Milan2mecha/zdroj/stl/drzak_izolatoru.stl

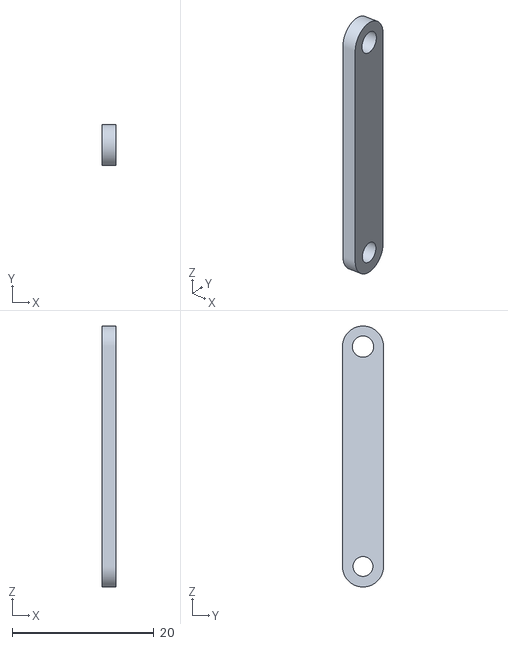
[picture p23: CAD file, 2023-06-30]
stl/drzak_izolatoru.stl
2.00 x 5.80 x 36.8
