Milan2mecha/zdroj/stl/zadní kryt.stl

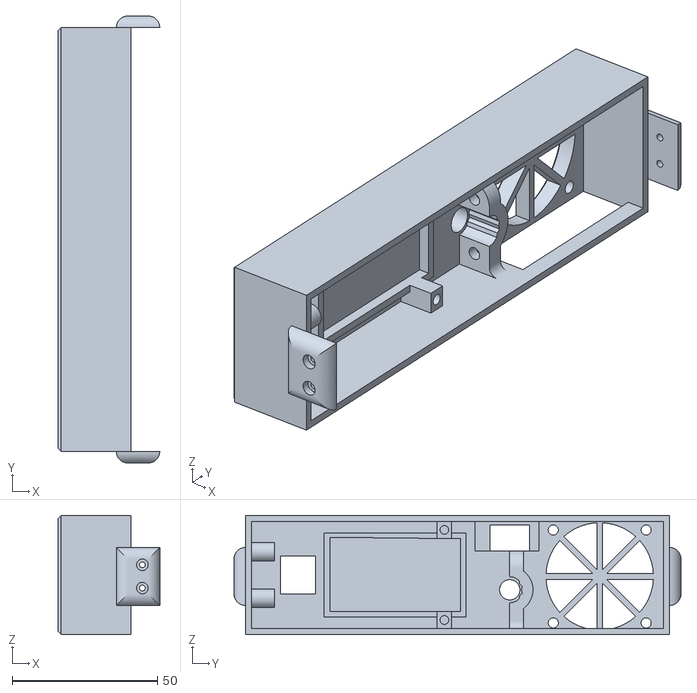
[picture p24: CAD file, 2023-04-14]
stl/zadní kryt.stl
35.0 x 154.0 x 41.0
