Milan2mecha/zdroj/stl/západka.stl

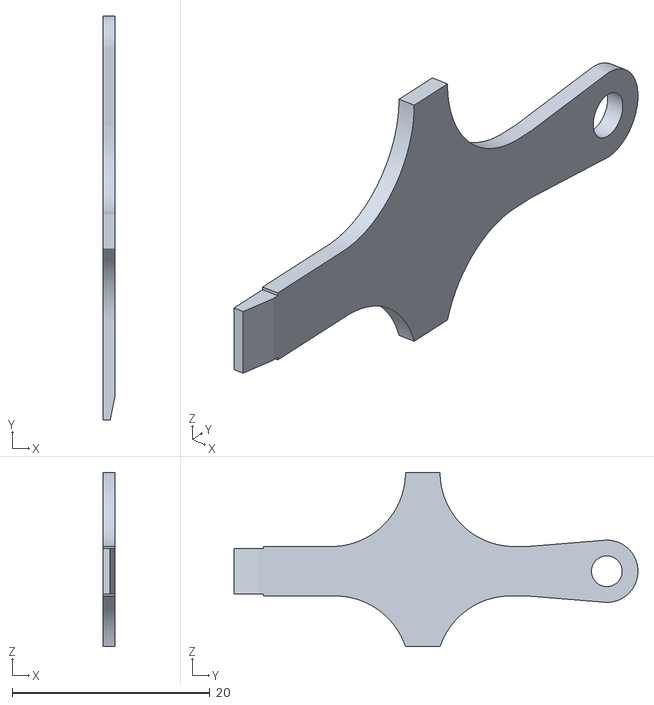
[picture p25: CAD file, 2022-03-03]
stl/západka.stl
1.25 x 40.8 x 17.6
