Milan2mecha/zdroj/stl/uchytka desek.stl

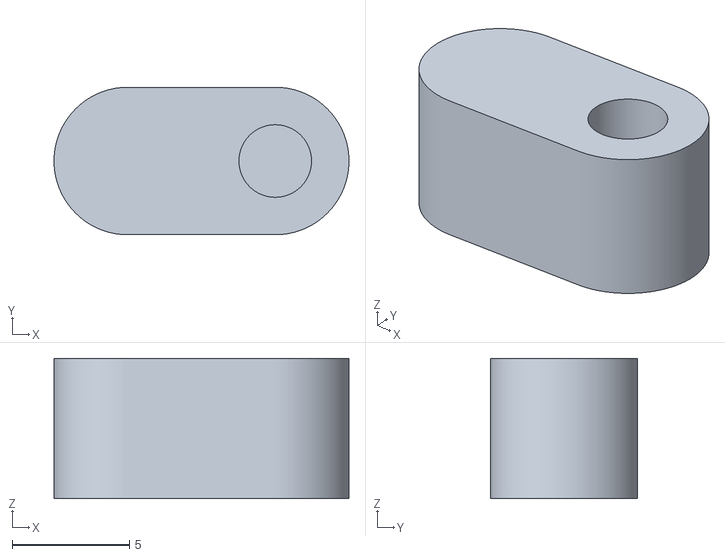
[picture p26: CAD file, 2022-02-09]
stl/uchytka desek.stl
12.6 x 6.30 x 6.00
