Milan2mecha/zdroj/stl/clona.stl

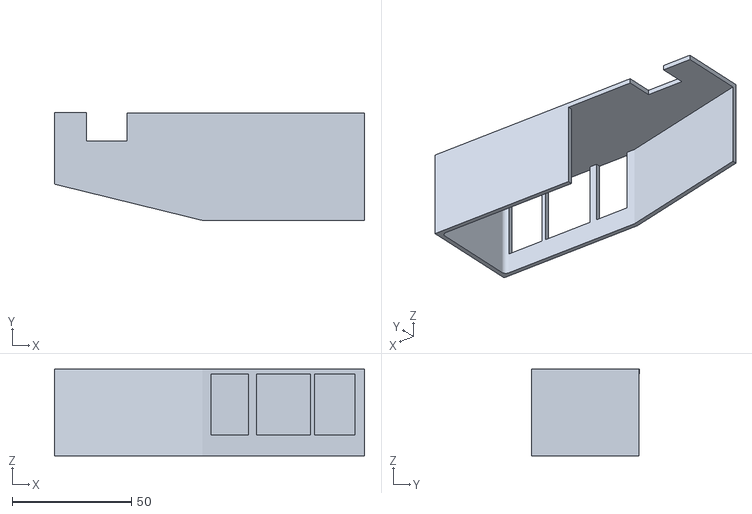
[picture p27: CAD file, 2022-02-09]
stl/clona.stl
130.0 x 45.2 x 36.4
