Milan2mecha/zdroj/stl/krytka enkoderu v2.stl

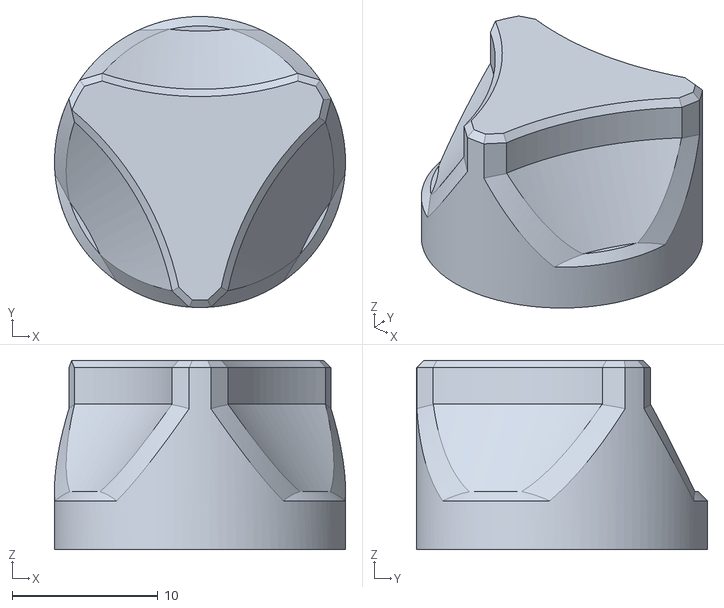
[picture p28: CAD file, 2022-01-17]
stl/krytka enkoderu v2.stl
20.0 x 20.0 x 13.0
