Milan2mecha/zdroj/stl/left.stl

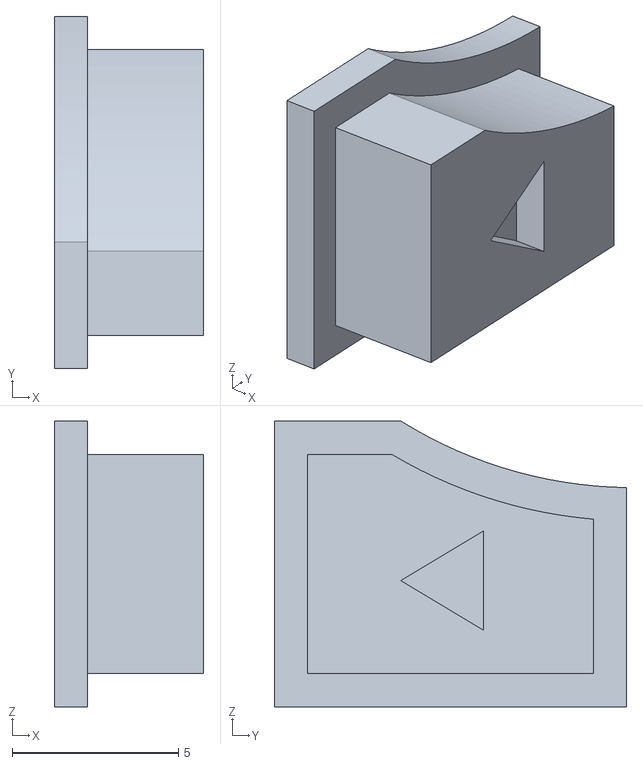
[picture p29: CAD file, 2022-01-17]
stl/left.stl
4.50 x 10.6 x 8.60
