Milan2mecha/zdroj/stl/příchytka.stl

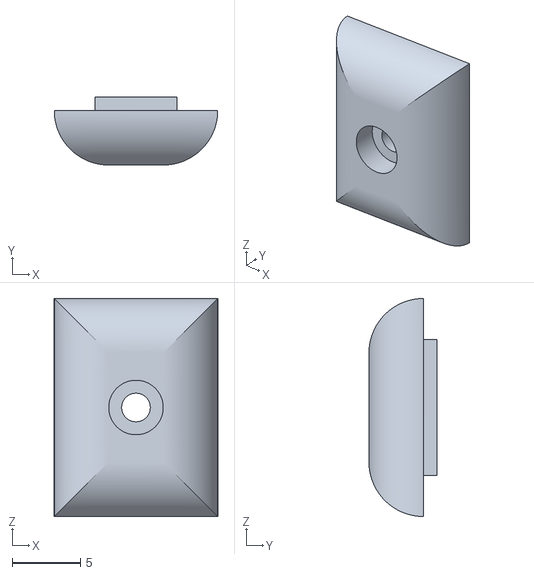
[picture p30: CAD file, 2022-01-17]
stl/příchytka.stl
12.0 x 5.00 x 16.0
