Milan2mecha/zdroj/stl/menu.stl

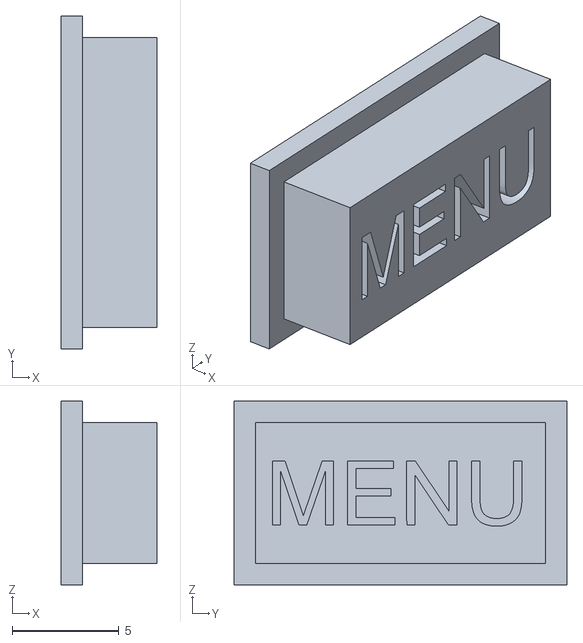
[picture p31: CAD file, 2022-01-17]
stl/menu.stl
4.50 x 15.6 x 8.60
