Milan2mecha/zdroj/stl/ovládací panel.stl

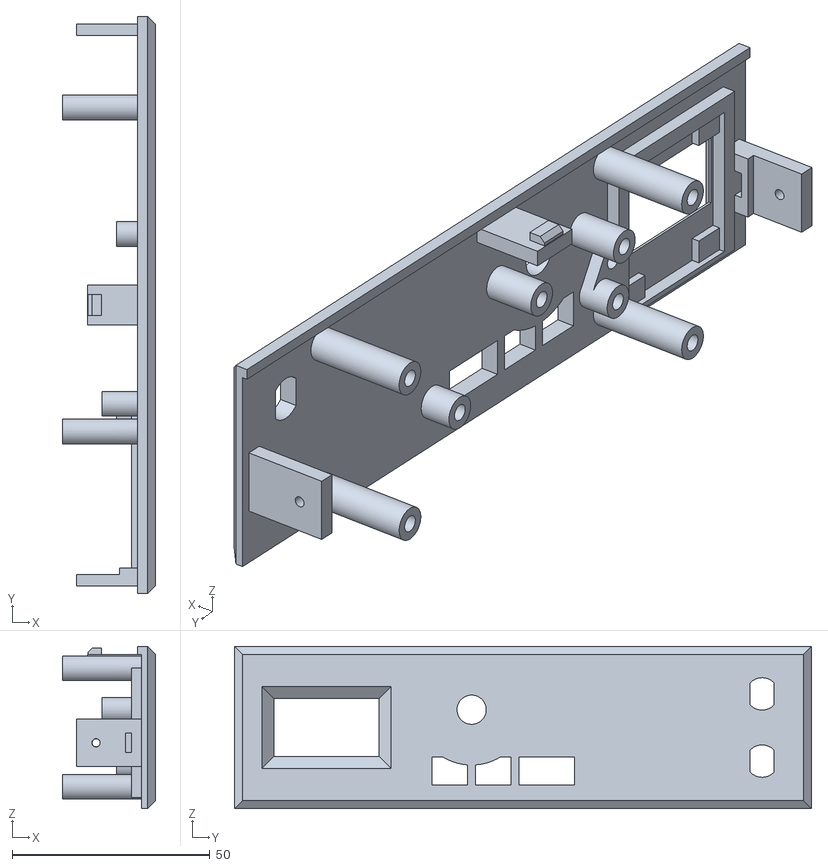
[picture p32: CAD file, 2022-01-17]
stl/ovládací panel.stl
23.5 x 146.0 x 41.0
