Milan2mecha/zdroj/(list of files, cad)

Other CAD files:
stl/right.stl
