Milan2mecha/zdroj/schéma.pdf

# Deska microkontroleru STM32F103C8T6

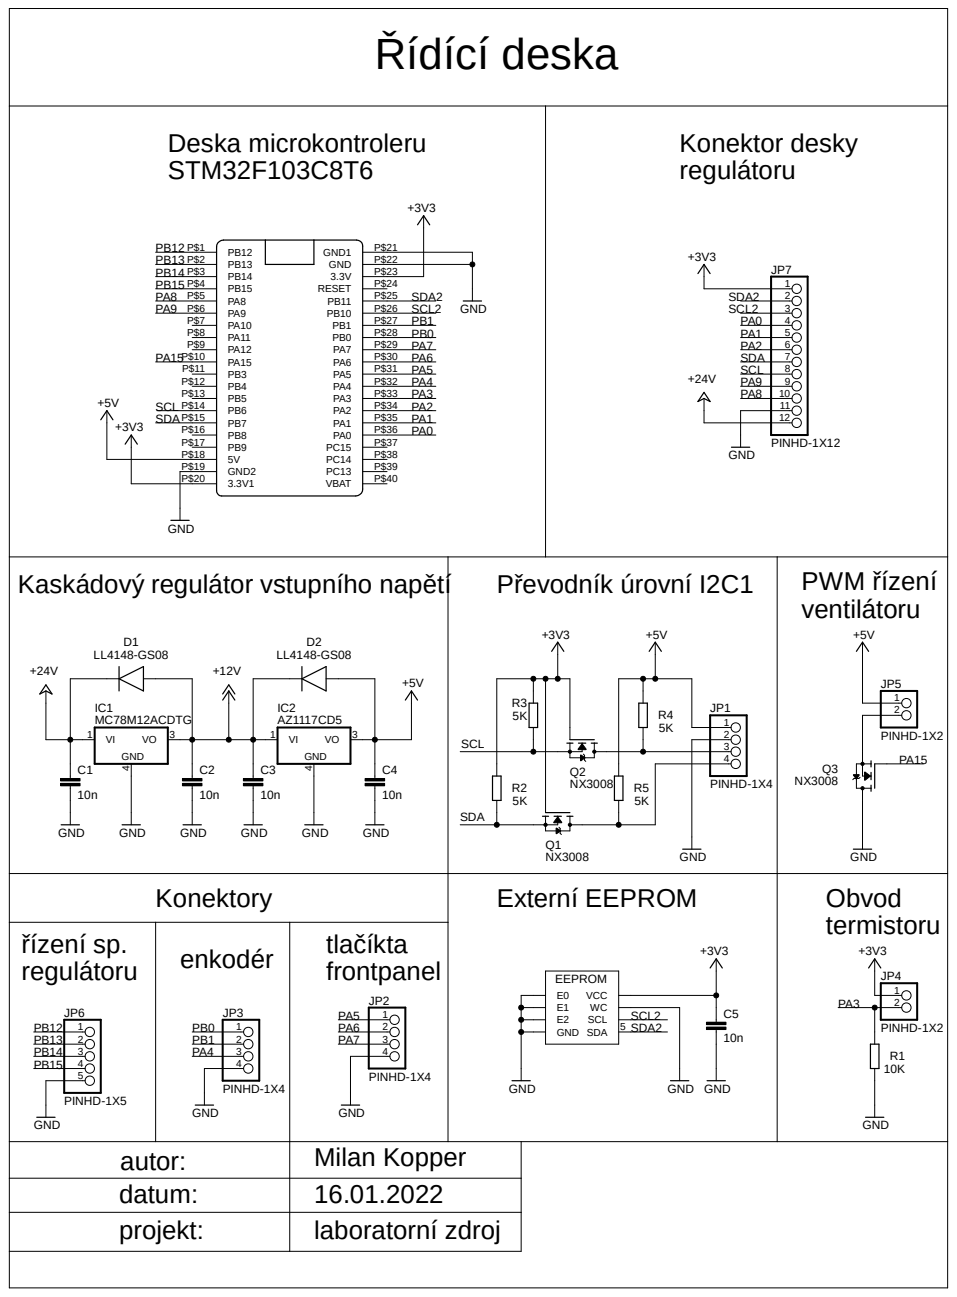
[picture p33: page 1]

Kaskádový regulátor vstupního napětí

autor: | Milan Kopper
datum: | 16.01.2022
projekt: | laboratorní zdroj
