Milan2mecha/zdroj/clona.pdf

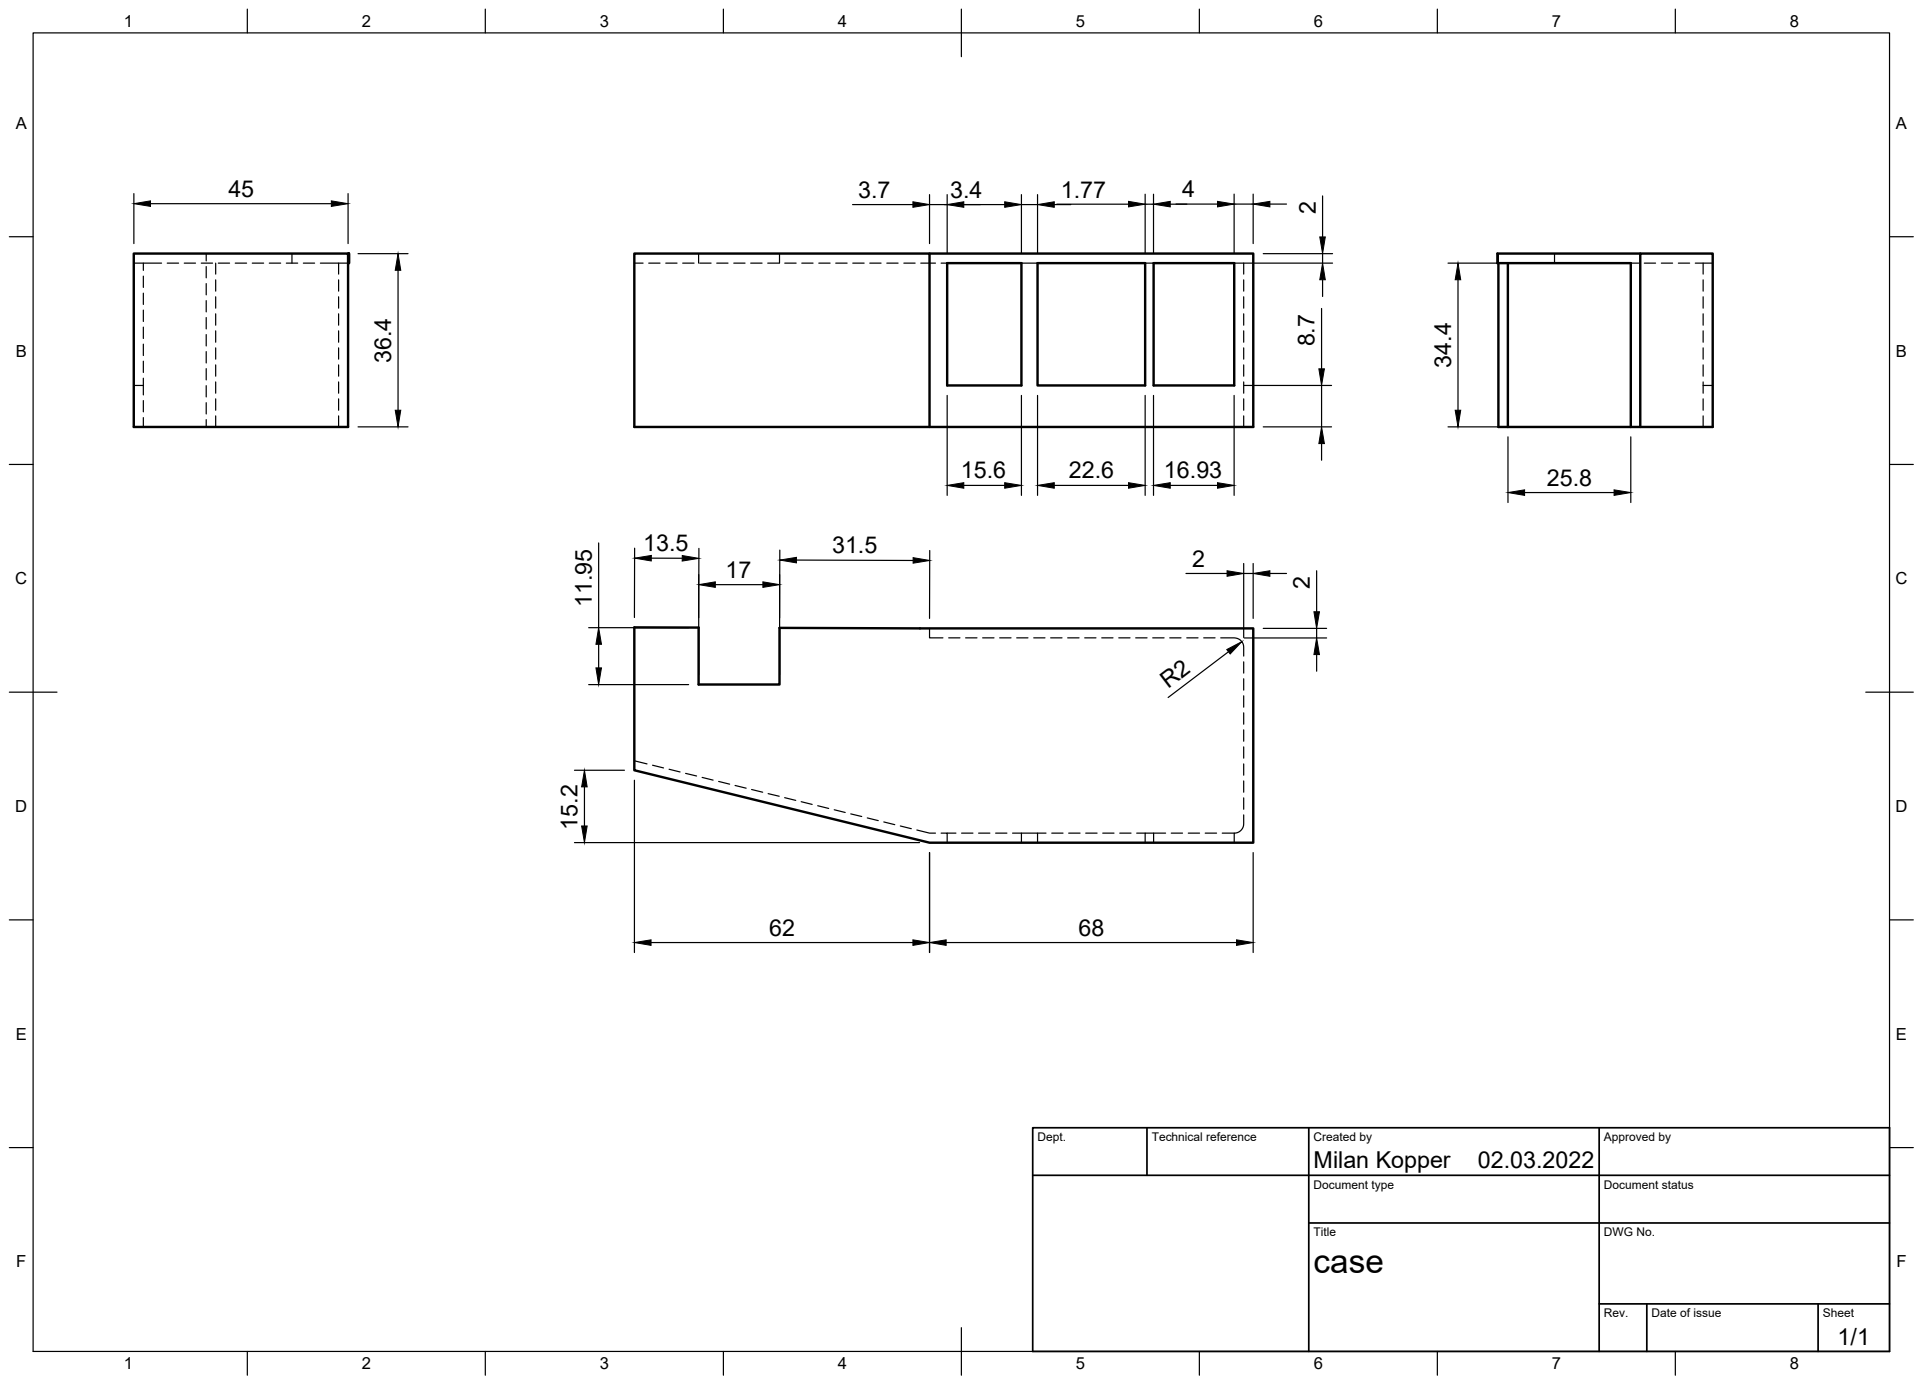
[picture p34: page 1]
Title; DWG No.; Rev.; Date of issue; Sheet

Dept. | Technical reference | Created by Milan Kopper 02.03.2022 | Approved by

Document type | Document status
