Milan2mecha/zdroj/příchytka.pdf

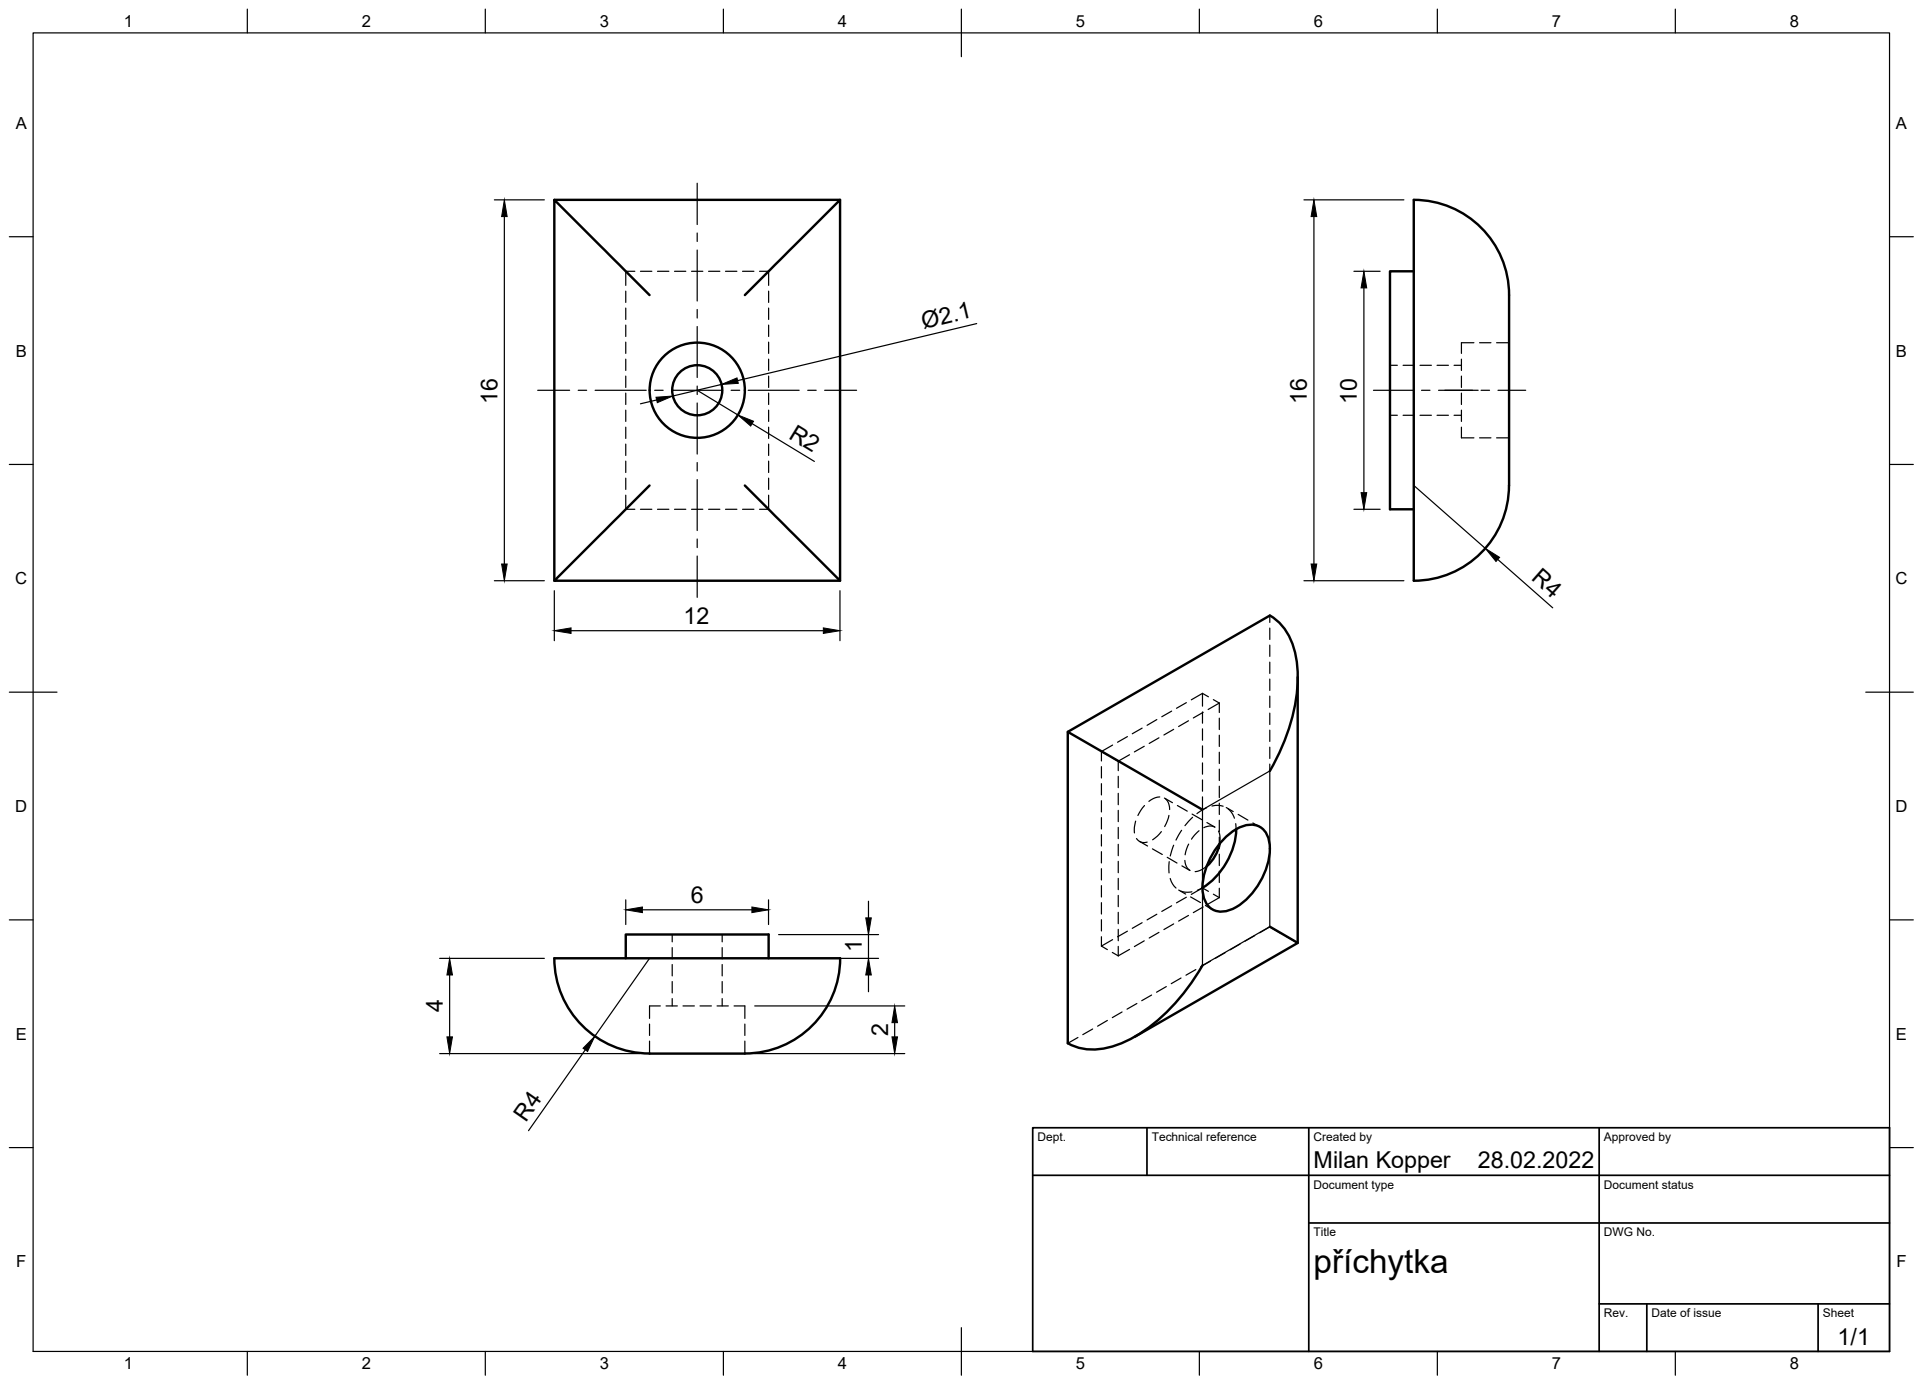
[picture p35: page 1]
Title; DWG No.; Rev.; Date of issue; Sheet

Dept. | Technical reference | Created by Milan Kopper 28.02.2022 | Approved by

Document type | Document status
