Milan2mecha/zdroj/ovládací panel.pdf

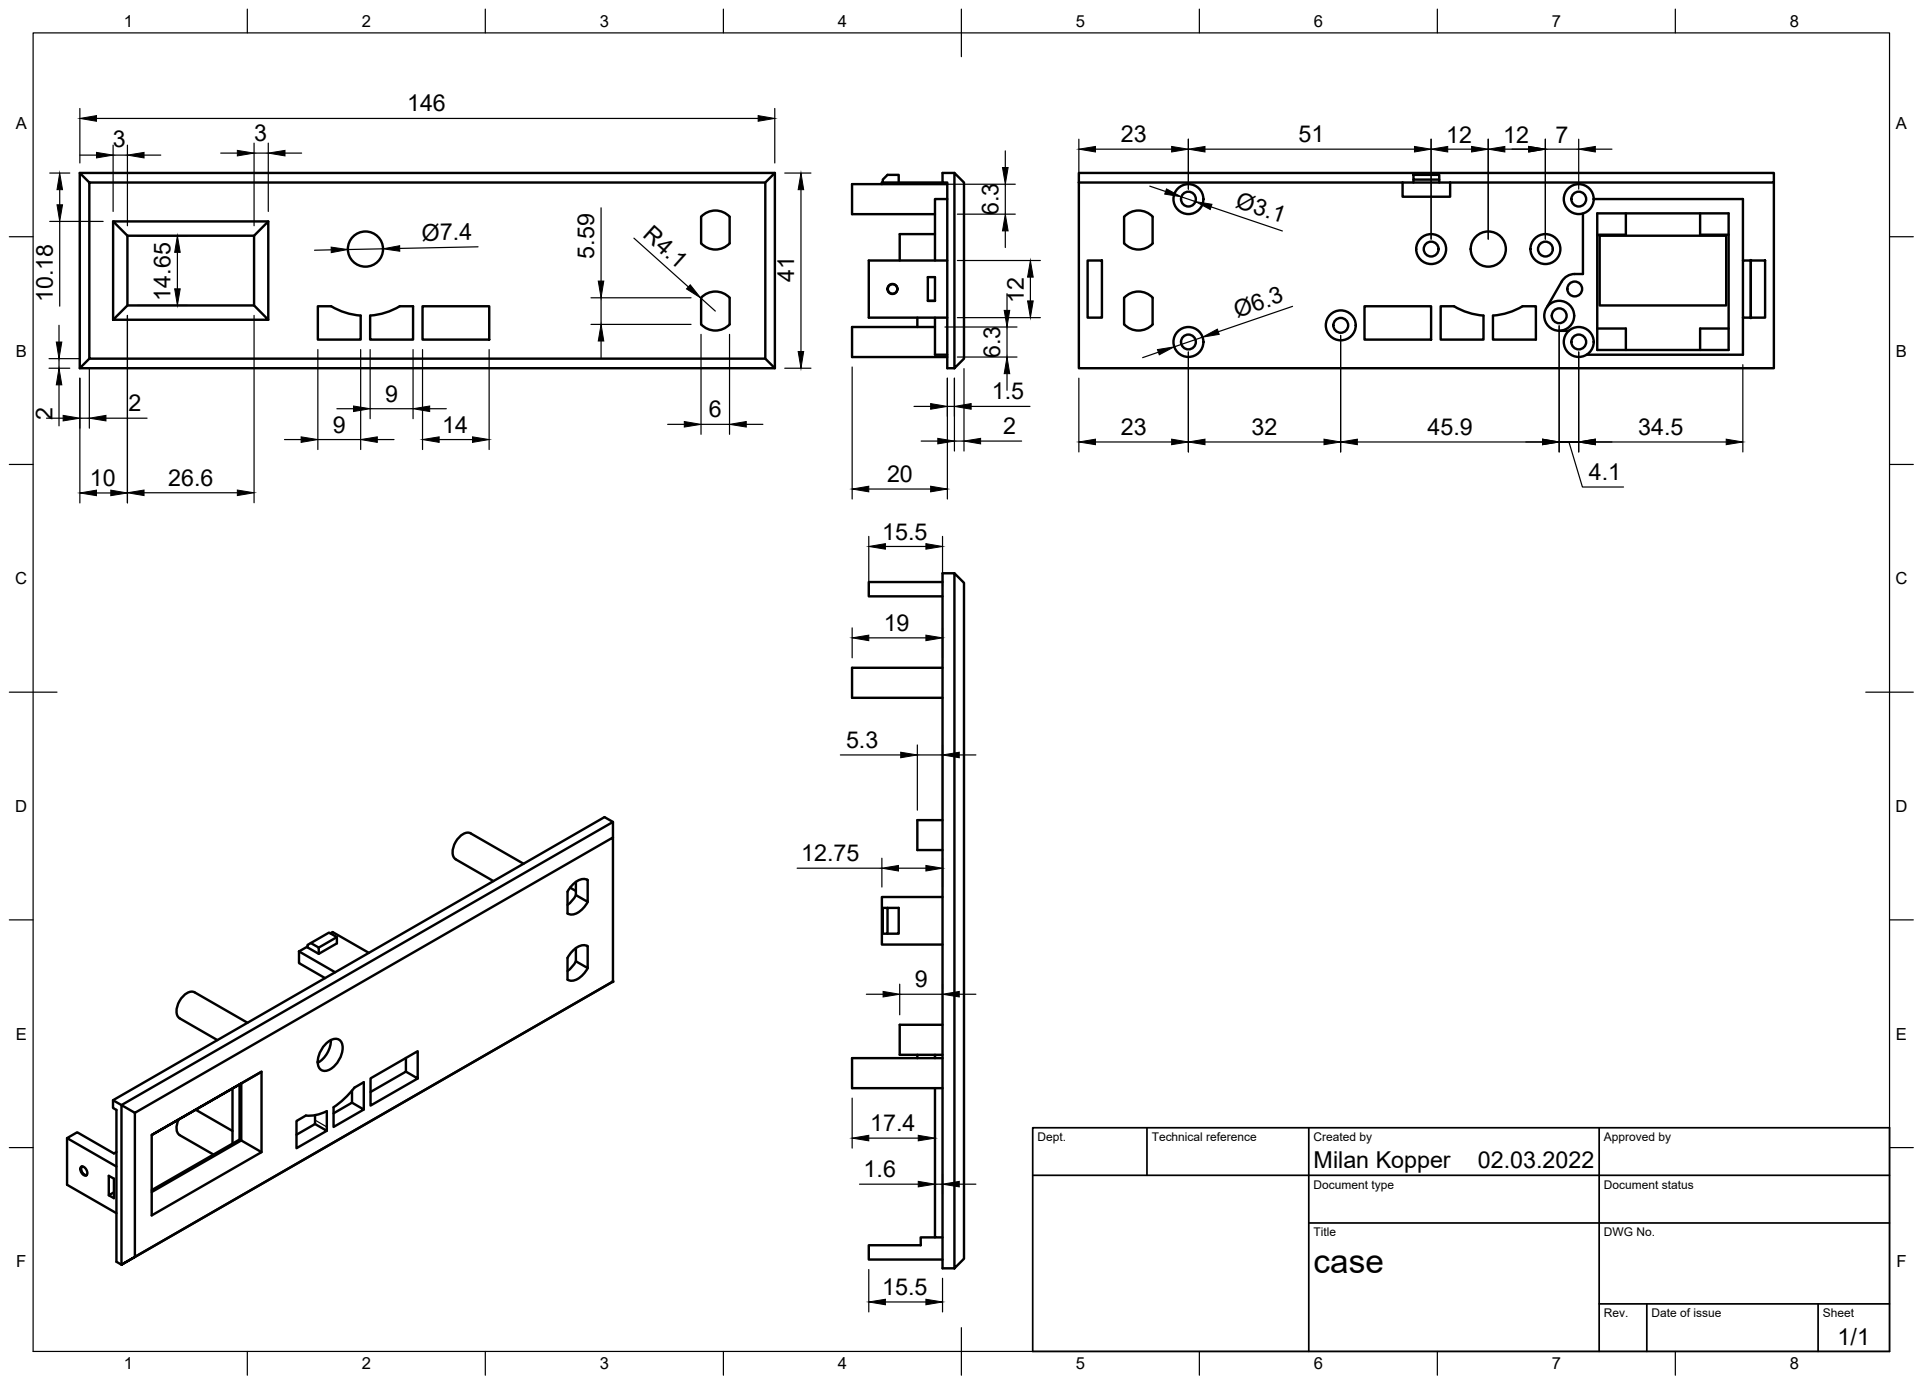
[picture p36: page 1]
Title; DWG No.; Rev.; Date of issue; Sheet; Milan Kopper 41

Dept. | Technical reference | Created by 02.03.2022 | Approved by

Document type | Document status
