Milan2mecha/zdroj/desky plošných spojů/řídicí deska.brd

## EAGLE design desky plošných spojů/řídicí deska.brd (2022-02-02)

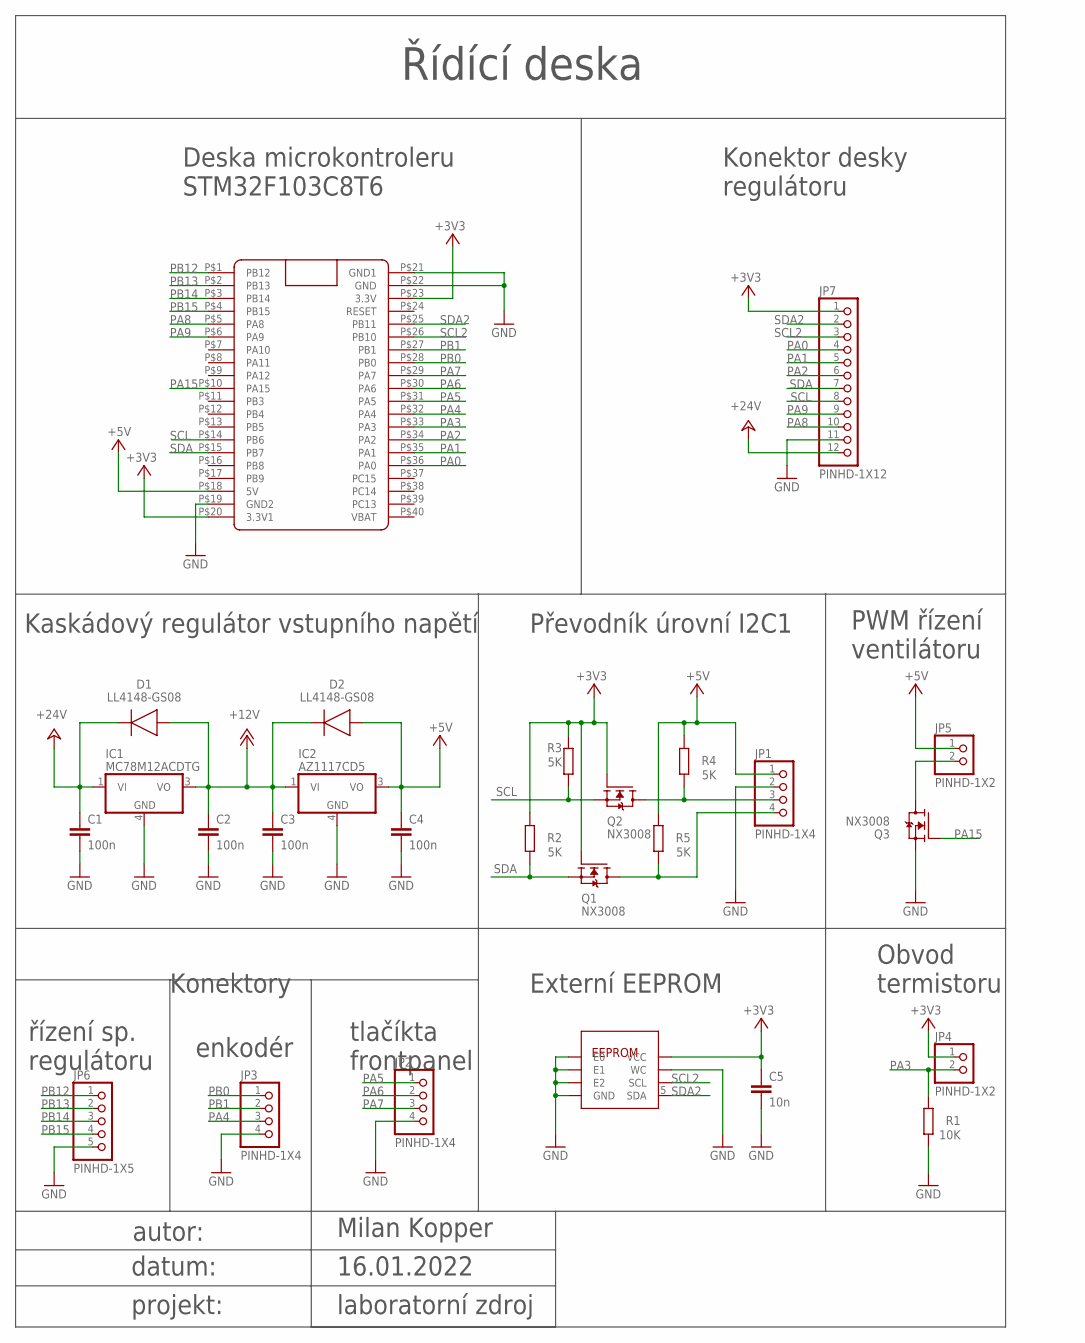
[picture p37: schematic řídicí deska.sch]

Parts:
C1, C2, C3, C4: 100n; C0805
C5: 10n; C0805
D1, D2: LL4148-GS08; DIOMELF3516
IC1: MC78M12ACDTG; DPACK_3
IC2: AZ1117CD5; DPACK_3
JP1, JP2, JP3: PINHD-1X4; 1X04
JP4, JP5: PINHD-1X2; 1X02
JP6: PINHD-1X5; 1X05
JP7: PINHD-1X12; 1X12
Q1, Q2, Q3: NX3008; SOT95P240X110-3N
R1: 10K; R0805
R2, R3, R4, R5: 5K; R0805
U$1: BLUE_PILL
U$2: M24CXX; SO8

Connections:
+3V3: C5.1, JP4.1, JP7.1, Q1.1 (G), Q2.1 (G), R2.2, R3.2, U$1.P$20 (3.3V1), U$1.P$23 (3.3V), U$2.8 (VCC)
+5V: C4.1, D2.2 (A), IC2.3 (VO), JP1.1, JP5.1, R4.2, R5.2, U$1.P$18 (5V)
+12V: C2.1, C3.1, D1.2 (A), D2.1 (C), IC1.3 (VO), IC2.1 (VI)
+24V: C1.1, D1.1 (C), IC1.1 (VI), JP7.12
GND: C1.2, C2.2, C3.2, C4.2, C5.2, IC1.4 (GND), IC2.4 (GND), JP1.2, JP2.4, JP3.4, JP6.5, JP7.11, Q3.2 (S), R1.1, U$1.P$19 (GND2), U$1.P$21 (GND1), U$1.P$22 (GND), U$2.1 (E0), U$2.2 (E1), U$2.3 (E2), U$2.4 (GND), U$2.7 (WC)
unnamed: JP5.2, Q3.3 (D)
unnamed: JP1.3, Q2.3 (D), R4.1
unnamed: JP1.4, Q1.3 (D), R5.1
PA0: JP7.4, U$1.P$36 (PA0)
PA1: JP7.5, U$1.P$35 (PA1)
PA2: JP7.6, U$1.P$34 (PA2)
PA3: JP4.2, R1.2, U$1.P$33 (PA3)
PA4: JP3.3, U$1.P$32 (PA4)
PA5: JP2.1, U$1.P$31 (PA5)
PA6: JP2.2, U$1.P$30 (PA6)
PA7: JP2.3, U$1.P$29 (PA7)
PA8: JP7.10, U$1.P$5 (PA8)
PA9: JP7.9, U$1.P$6 (PA9)
PA15: Q3.1 (G), U$1.P$10 (PA15)
PB0: JP3.1, U$1.P$28 (PB0)
PB1: JP3.2, U$1.P$27 (PB1)
PB12: JP6.1, U$1.P$1 (PB12)
PB13: JP6.2, U$1.P$2 (PB13)
PB14: JP6.3, U$1.P$3 (PB14)
PB15: JP6.4, U$1.P$4 (PB15)
SCL: JP7.8, Q2.2 (S), R3.1, U$1.P$14 (PB6)
SCL2: JP7.3, U$1.P$26 (PB10), U$2.6 (SCL)
SDA: JP7.7, Q1.2 (S), R2.1, U$1.P$15 (PB7)
SDA2: JP7.2, U$1.P$25 (PB11), U$2.5 (SDA)

Notes on the sheet:
Kaskádový regulátor vstupního napětí
Konektory
řízení sp. regulátoru
enkodér
tlačíkta frontpanel
Externí EEPROM
Převodník úrovní I2C1
Obvod termistoru
PWM řízení ventilátoru
Deska microkontroleru STM32F103C8T6
Konektor desky regulátoru
Řídící deska
autor:
datum:
projekt:
Milan Kopper
16.01.2022
laboratorní zdroj

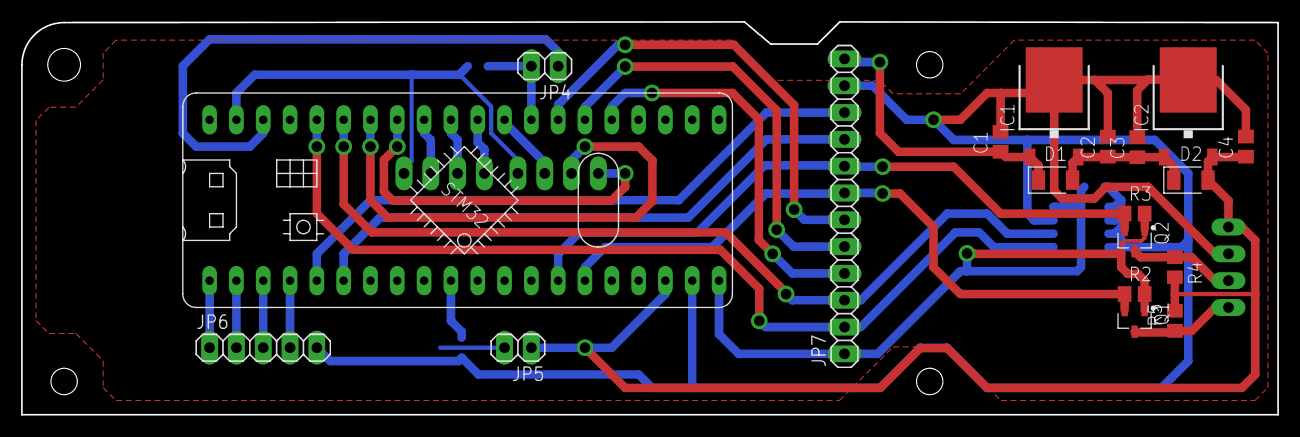
[picture p38: board řídicí deska.brd from above]

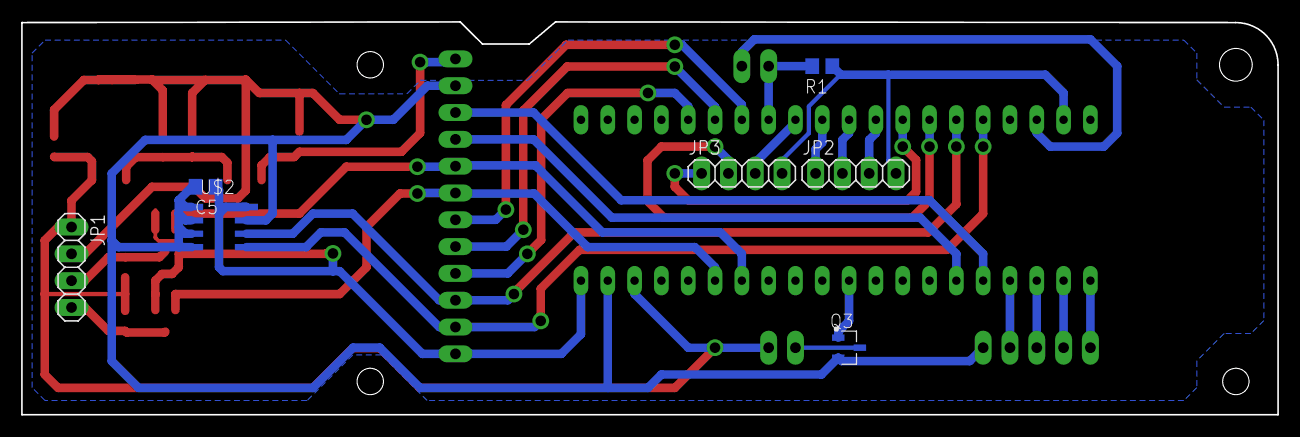
[picture p39: board řídicí deska.brd from below]

Board: 2 copper layers, 119.0 x 37.2 mm, 26 parts (7 on the bottom side), 29 nets.
