Milan2mecha/zdroj/desky plošných spojů/pulzní regulátor.brd

## EAGLE design desky plošných spojů/pulzní regulátor.brd (2022-02-07)

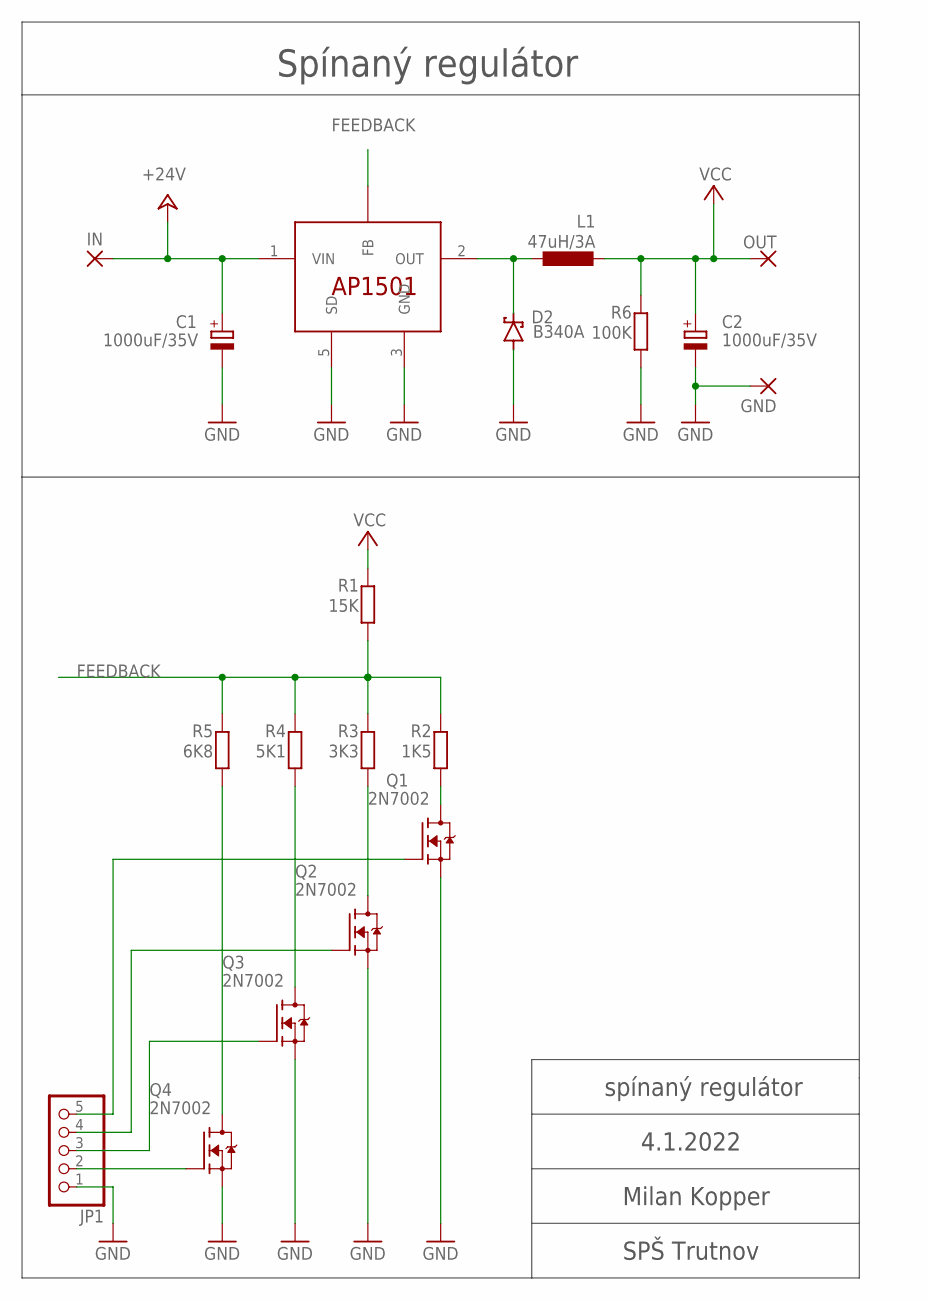
[picture p40: schematic pulzní regulátor.sch]

Parts:
C1, C2: 1000uF/35V; E5-10,5
D2: B340A; SMB
GND: 3,17/1,3
IN: 3,17/1,3
JP1: PINHD-1X5; 1X05
L1: 47uH/3A; DTMSS-16/0,033/6,0
OUT: 3,17/1,3
Q1, Q2, Q3, Q4: 2N7002; SOT95P240X110-3N
R1: 15K; R0805
R2: 1K5; R0805
R3: 3K3; R0805
R4: 5K1; R0805
R5: 6K8; R0805
R6: 100K; R0805
U$2: AP1501TO220; TO220-5

Connections:
+24V: C1.+, IN.1, U$2.1 (VIN)
FEEDBACK: R1.1, R2.2, R3.2, R4.2, R5.2, U$2.4 (FB)
GND: C1.-, C2.-, D2.A, GND.1, JP1.1, Q1.2 (S), Q2.2 (S), Q3.2 (S), Q4.2 (S), R6.1, U$2.3 (GND), U$2.5 (SD)
unnamed: Q4.3 (D), R5.1
unnamed: D2.C, L1.P$1 (1), U$2.2 (OUT)
unnamed: JP1.2, Q4.1 (G)
unnamed: Q1.3 (D), R2.1
unnamed: JP1.3, Q3.1 (G)
unnamed: JP1.4, Q2.1 (G)
unnamed: JP1.5, Q1.1 (G)
unnamed: Q2.3 (D), R3.1
unnamed: Q3.3 (D), R4.1
VCC: C2.+, L1.P$2 (2), OUT.1, R1.2, R6.2

Notes on the sheet:
Spínaný regulátor
spínaný regulátor
4.1.2022
Milan Kopper
SPŠ Trutnov

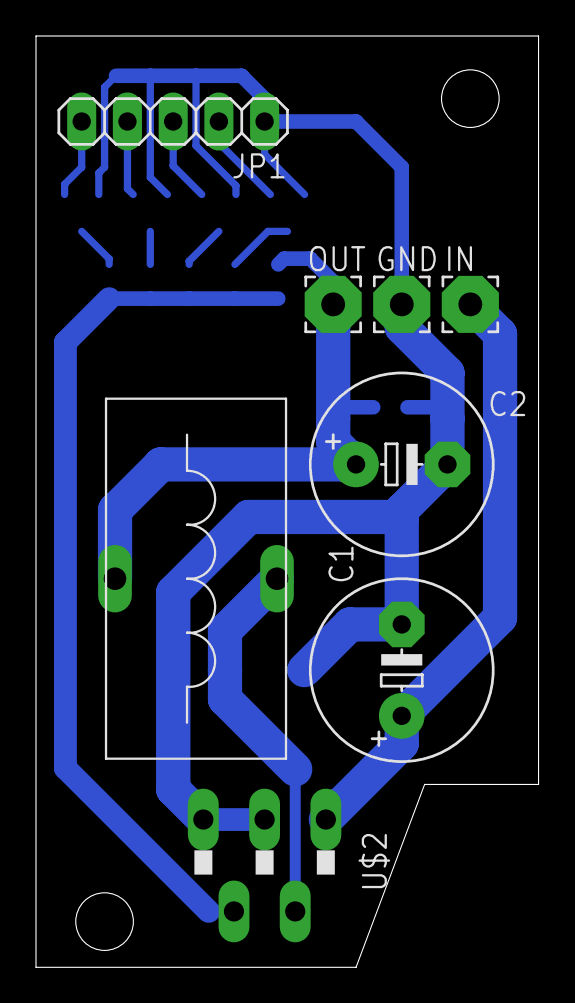
[picture p41: board pulzní regulátor.brd from above]

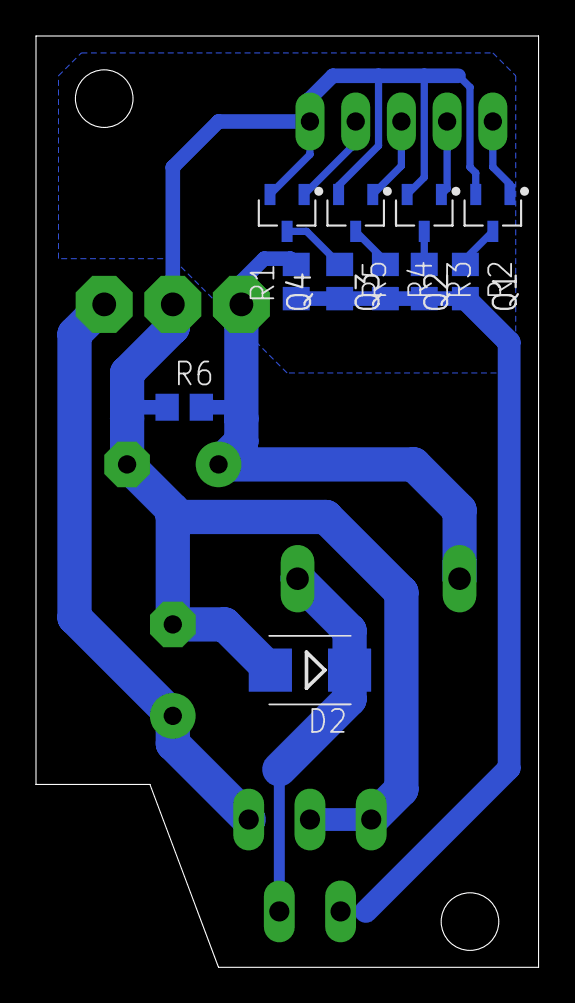
[picture p42: board pulzní regulátor.brd from below]

Board: 2 copper layers, 27.9 x 51.7 mm, 19 parts (11 on the bottom side), 13 nets.
