Milan2mecha/zdroj/desky plošných spojů/enkoder.brd

## EAGLE design desky plošných spojů/enkoder.brd (2022-01-17)

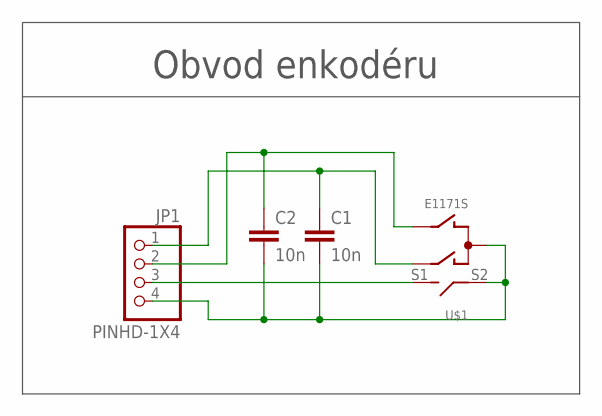
[picture p43: schematic enkoder.sch]

Parts:
C1, C2: 10n; C0805
JP1: PINHD-1X4; 1X04
U$1: E1171S

Connections:
unnamed: C1.2, C2.2, JP1.4, U$1.C, U$1.S2
unnamed: JP1.3, U$1.S1
unnamed: C1.1, JP1.1, U$1.A
unnamed: C2.1, JP1.2, U$1.B

Notes on the sheet:
Obvod enkodéru

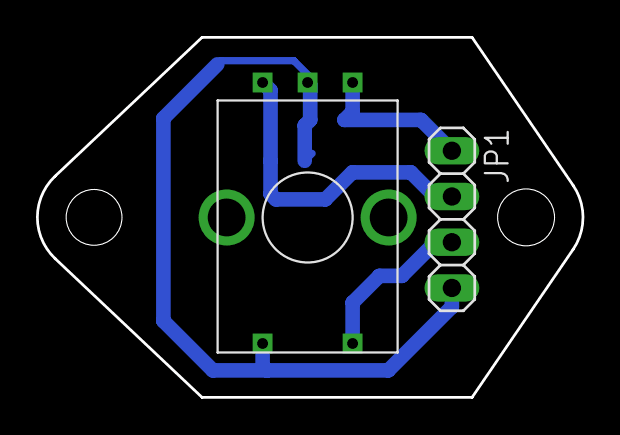
[picture p44: board enkoder.brd from above]

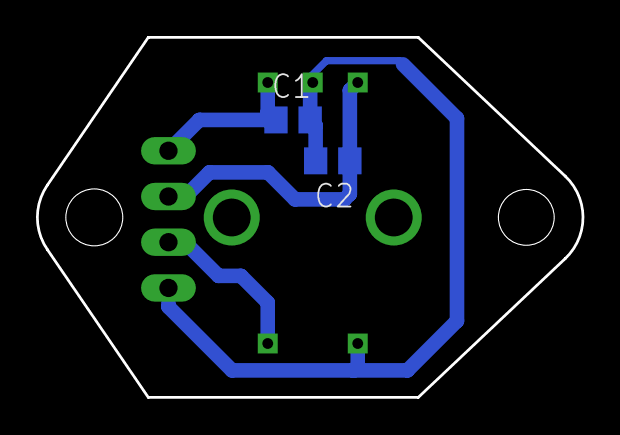
[picture p45: board enkoder.brd from below]

Board: 2 copper layers, 30.3 x 20.0 mm, 4 parts (2 on the bottom side), 4 nets.
