Milan2mecha/zdroj/desky plošných spojů/tlacitka.brd

## EAGLE design desky plošných spojů/tlacitka.brd (2022-03-02)

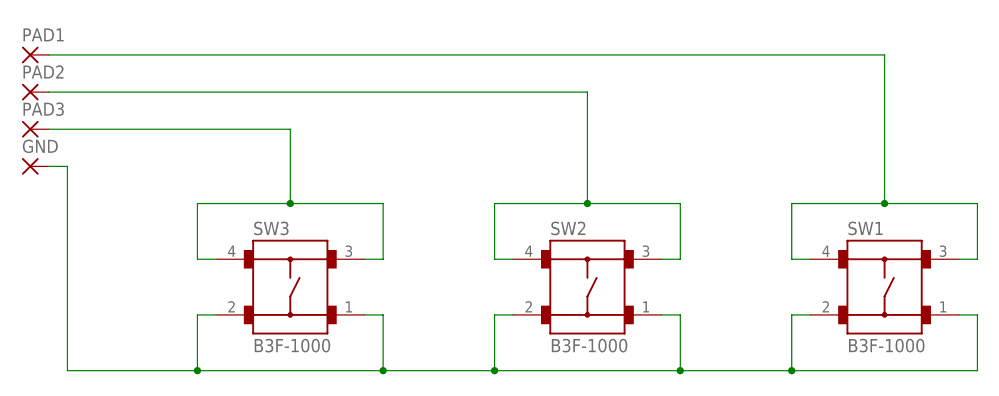
[picture p46: schematic tlacitka.sch]

Parts:
GND: SMD5; SMD2,54-5,08
PAD1, PAD2, PAD3: SMD5; SMD2,54-5,08
SW1, SW2, SW3: B3F-1000

Connections:
unnamed: PAD1.1, SW1.3, SW1.4
unnamed: PAD2.1, SW2.3, SW2.4
unnamed: GND.1, SW1.1, SW1.2, SW2.1, SW2.2, SW3.1, SW3.2
unnamed: PAD3.1, SW3.3, SW3.4

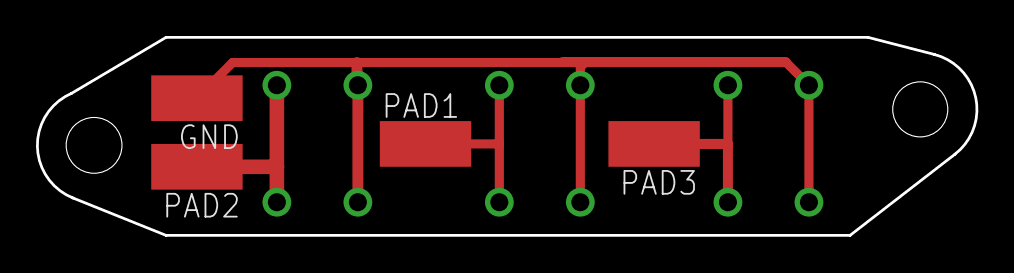
[picture p47: board tlacitka.brd from above]

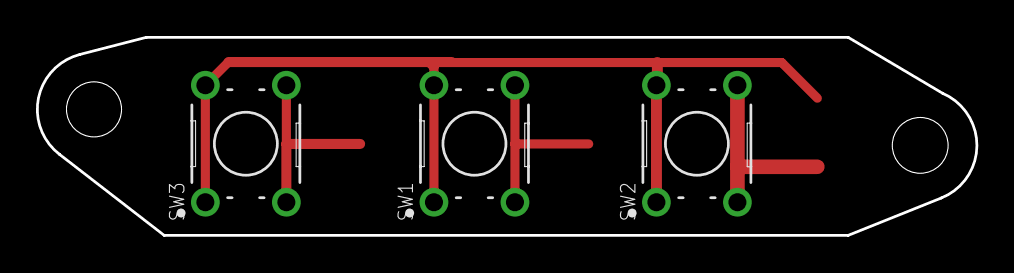
[picture p48: board tlacitka.brd from below]

Board: 2 copper layers, 52.2 x 11.0 mm, 7 parts (3 on the bottom side), 4 nets.
