Milan2mecha/zdroj/desky plošných spojů/linearni_zdroj.brd

## EAGLE design desky plošných spojů/linearni_zdroj.brd (2022-02-12)

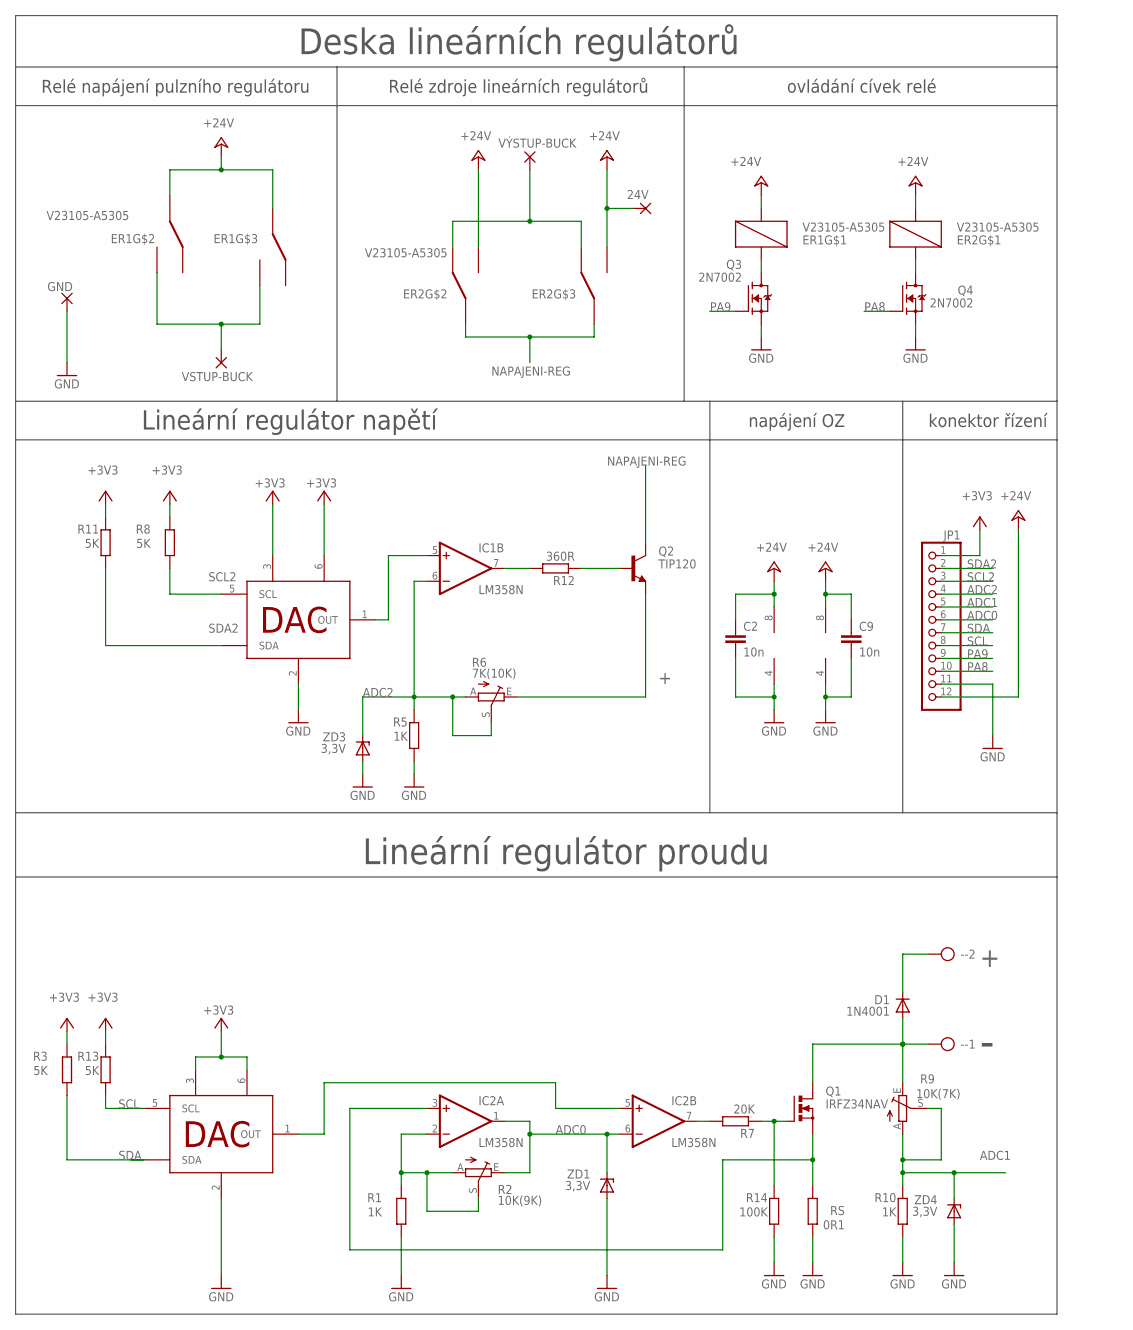
[picture p49: schematic linearni_zdroj.sch]

Parts:
24V: 3,81/1,4
-: AK500/2
C2, C9: 10n; C0805
D1: 1N4001; DO35-7B
ER1, ER2: V23105-A5305; V23105-A5305-A201
GND: 3,81/1,4
IC1, IC2: LM358N; DIL08
JP1: PINHD-1X12; 1X12
Q1: IRFZ34NAV; TO220AV
Q2: TIP120; TO220V
Q3, Q4: 2N7002; SOT95P240X110-3N
R1, R5, R10: 1K; R0805
R2: 10K(9K); CA6V
R3, R8, R11, R13: 5K; R0805
R6: 7K(10K); CA6V
R7: 20K; R0805
R9: 10K(7K); CA6V
R12: 360R; R0805
R14: 100K; R0805
RS: 0R1; 0411/15
U$5, U$6: MCP4726; TSOT23-6
VSTUP-BUCK: 3,81/1,4
VÝSTUP-BUCK: 3,81/1,4
ZD1, ZD3, ZD4: 3,3V; MINIMELF

Connections:
+: -.2, D1.C, Q2.3 (E), R6.E
+3V3: JP1.1, R3.2, R8.2, R11.2, R13.2, U$5.3 (VDD), U$5.6 (VREF), U$6.3 (VDD), U$6.6 (VREF)
+24V: 24V.1, C2.1, C9.1, ER1.1, ER1.4 (1), ER1.13 (1), ER2.1, ER2.8 (3), ER2.9 (3), IC1.8 (V+), IC2.8 (V+), JP1.12
ADC0: IC2.1 (OUT), IC2.6 (-IN), JP1.6, R2.E, ZD1.C
ADC1: JP1.5, R9.A, R9.S, R10.2, ZD4.C
ADC2: IC1.6 (-IN), JP1.4, R5.2, R6.A, R6.S, ZD3.C
GND: C2.2, C9.2, GND.1, IC1.4 (V-), IC2.4 (V-), JP1.11, Q3.2 (S), Q4.2 (S), R1.1, R5.1, R10.1, R14.1, RS.1, U$5.2 (VSS), U$6.2 (VSS), ZD1.A, ZD3.A, ZD4.A
unnamed: IC2.7 (OUT), R7.2
unnamed: Q1.G, R7.1, R14.2
unnamed: IC2.2 (-IN), R1.2, R2.A, R2.S
unnamed: Q2.1 (B), R12.1
unnamed: IC2.5 (+IN), U$5.1 (OUT)
unnamed: -.1, D1.A, Q1.D, R9.E
unnamed: IC1.5 (+IN), U$6.1 (OUT)
unnamed: ER2.6 (2), ER2.11 (2), VÝSTUP-BUCK.1
unnamed: IC1.7 (OUT), R12.2
unnamed: ER1.16, Q3.3 (D)
unnamed: ER2.16, Q4.3 (D)
unnamed: ER1.8 (3), ER1.9 (3), VSTUP-BUCK.1
unnamed: IC2.3 (+IN), Q1.S, RS.2
NAPAJENI-REG: ER2.4 (1), ER2.13 (1), Q2.2 (C)
PA8: JP1.10, Q4.1 (G)
PA9: JP1.9, Q3.1 (G)
SCL: JP1.8, R13.1, U$5.5 (SCL)
SCL2: JP1.3, R8.1, U$6.5 (SCL)
SDA: JP1.7, R3.1, U$5.4 (SDA)
SDA2: JP1.2, R11.1, U$6.4 (SDA)

Notes on the sheet:
Lineární regulátor napětí
napájení OZ
Relé zdroje lineárních regulátorů
Relé napájení pulzního regulátoru
konektor řízení
Lineární regulátor proudu
ovládání cívek relé
Deska lineárních regulátorů

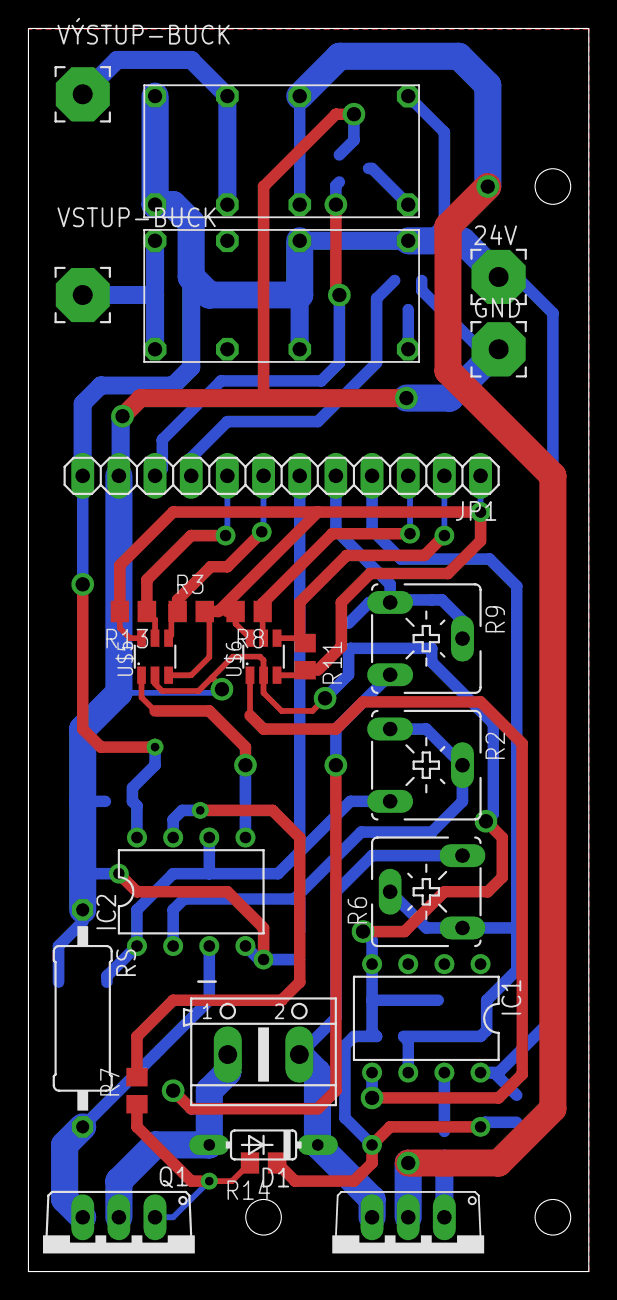
[picture p50: board linearni_zdroj.brd from above]

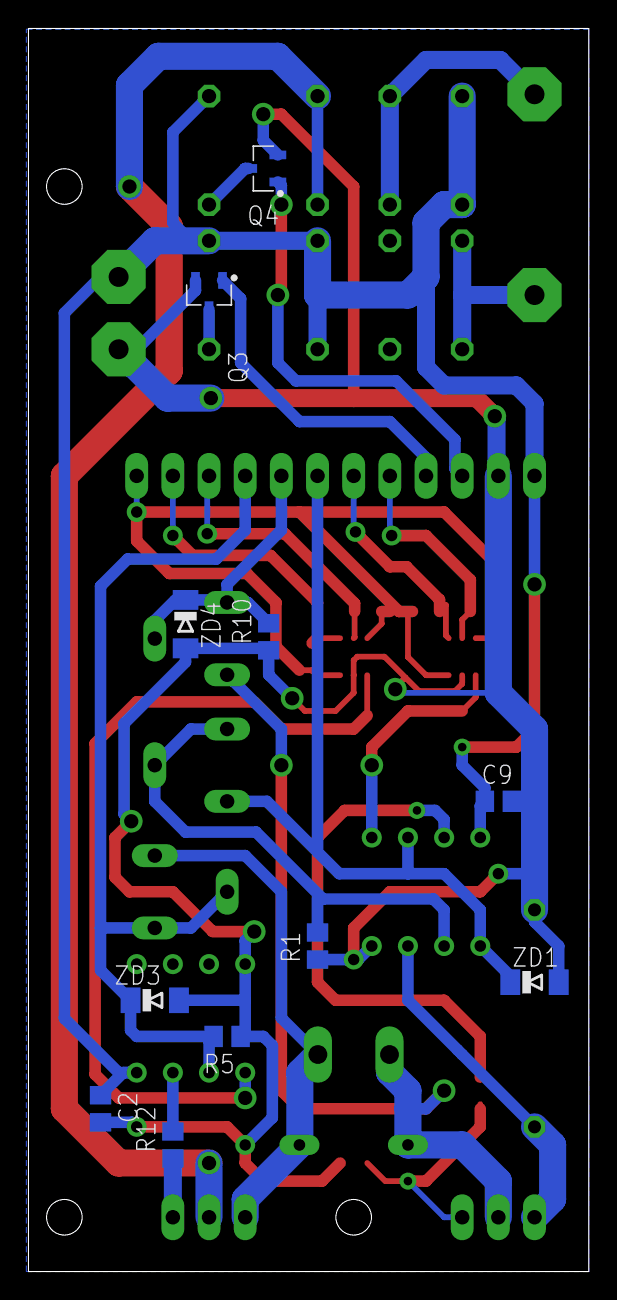
[picture p51: board linearni_zdroj.brd from below]

Board: 2 copper layers, 39.4 x 87.3 mm, 36 parts (11 on the bottom side), 27 nets.
