Milan2mecha/zdroj/SW/windows/main/main.cpp

#include "widget.h"

#include <QApplication>

#include <QLocale>
#include <QTranslator>

int main(int argc, char *argv[])
{
    QApplication a(argc, argv);
    QCoreApplication::setApplicationName("Zdroj GUI");
    QTranslator translator;
    const QStringList uiLanguages = QLocale::system().uiLanguages();
    for (const QString &locale : uiLanguages) {
        const QString baseName = "main_" + QLocale(locale).name();
        if (translator.load(":/i18n/" + baseName)) {
            a.installTranslator(&translator);
            break;
        }
    }
    Widget w;
    w.show();

    return a.exec();
}
