Milan2mecha/zdroj/SW/windows/main/widget.h

#ifndef WIDGET_H
#define WIDGET_H

#include <QWidget>
#include <QtSerialPort/QSerialPort>
#include <QLabel>
#include <QDoubleSpinBox>
#include <QPushButton>
#include <QTabWidget>


class Widget : public QWidget

{
    Q_OBJECT

private:
    //grafické prvky
    QLabel *voltdis;
    QLabel *currentdis;
    QLabel *powerdis;
    QLabel *tempdis;
    QLabel *ventdis;
    QPushButton *tritri;
    QPushButton *pet;
    QPushButton *dvanact;
    QTabWidget *Tabs;


    //spinboxy
    QDoubleSpinBox *CCspin;
    QDoubleSpinBox *CVspin;

    void openSerialPort(QString);
    void closeSerialPort();
    QString readData();
    void writeData(const QByteArray  &data);
    QSerialPort *m_serial;
    QString* mainstr;
    QByteArray* send;
public:

    Widget(QWidget *parent = nullptr);

    ~Widget();

};

#endif // WIDGET_H
