Milan2mecha/zdroj/(commit log)

2021-04-14 výkres
    [zdrojV20.brd, zdrojV20.sch]
2021-04-17 funkční kód volt + amper metr
2021-07-10 začátek prací na přidání ventilátoru
    [zdrojV20.brd, zdrojV20.sch, zdrojV21.brd, zdrojV21.sch]
2021-12-07 pokračování v základním návrhu
    [zdrojV21.brd, zdrojV21.sch]
2021-12-07 Základní vize zdroje v3.0
    [proudovyzdroj.brd, proudovyzdroj.sch]
2021-12-10 základní schéma
    [proudovyzdroj.brd, proudovyzdroj.sch]
2021-12-18 náznak řízení spínané části, úklid schématu
    [proudovyzdroj.brd, proudovyzdroj.sch]
2021-12-29 vytvořen modul stavitelného buck regulátoru
    [pulzní regulátor.brd, pulzní regulátor.sch]
2022-01-03 přidání řízení DAC1 a ADC
    [proudovyzdroj.brd, proudovyzdroj.sch, pulzní regulátor.brd]
2022-01-03 přepsáno na DMA ADC
2022-01-04 přidán hmatník encoderu
    [krytka encoderu v1.stl]
2022-01-06 přidán kód encodéru (bug: nahodně začne řídit cifru na které není cursor)
    [ovládací panel.sch]
2022-01-10 přidány kometáře, opravena chyba výpočtu děliče spínaného zdroje
    [odporyspinan.xlsx]
2022-01-11 opravena chyba pozice kurzoru v menu 1, změněn clock na externí, include knihoven eaglu.
    [odporyspinan.xlsx, ovládací panel.brd, pulzní regulátor.brd, pulzní regulátor.sch]
2022-01-12 Voila a enkodér funguje
    [ovládací panel.brd, ovládací panel.sch]
2022-01-17 přenesení do fusionu
    [ovládací panel.brd, ovládací panel.sch, proudovyzdroj.brd, proudovyzdroj.sch]
2022-01-17 export frontpanelu z fusionu
    [enkoder.brd, enkoder.sch, frontpanel.stl, krytka encoderu v1.stl, krytka enkoderu v2.stl, left.stl, menu.stl, příchytka.stl]
2022-01-17 Úprava BUCK regulátoru z 6A na 3A, osnova dokumentace
    [pulzní regulátor.brd, pulzní regulátor.sch]
2022-01-18 regulováný zdroj pro 3A kompletní + dokumentace ovládacího panelu
    [pulzní regulátor.brd, pulzní regulátor.sch]
2022-01-19 mírné úpravy dokumentace, přidání funkce pro zakázané stavy
    [errorlist.xlsx, odporyspinan.xlsx, pulzní regulátor.brd]
2022-01-20 přidána rozlévaná měď, rozšířena dokumentace
    [proudovyzdroj.brd, proudovyzdroj.sch, pulzní regulátor.brd, pulzní regulátor.sch, řídicí deska.brd, řídicí deska.sch]
2022-01-23 Přidán obvod řízení výběru zdroje lineárního regulátoru
    [proudovyzdroj.brd, proudovyzdroj.sch]
2022-01-23 přejmenování desky
    [linearni_zdroj.brd, linearni_zdroj.sch]
2022-01-26 zpřehlednění schématu
    [linearni_zdroj.brd, linearni_zdroj.sch]
2022-01-28 přidány pull-up rezistory I2C
    [linearni_zdroj.brd, linearni_zdroj.sch, odporyspinan.xlsx]
2022-02-02 oprava mosfet ventilátoru
    [odporyspinan.xlsx, řídicí deska.brd, řídicí deska.sch]
2022-02-04 zpřehledněno schéma spínaného zdroje a dokončena jeho dokumentace
    [odporyspinan.xlsx, pulzní regulátor.brd, pulzní regulátor.sch]
2022-02-06 deska lineárního regulátoru
    [linearni_zdroj.brd, linearni_zdroj.sch]
2022-02-07 přidání 3D modelu úpravy dokumentace
    [linearni_zdroj.brd, linearni_zdroj.sch, pulzní regulátor.brd, pulzní regulátor.sch]
2022-02-08 upratování schémy, dokumentace lineárního regulátoru napětí
    [linearni_zdroj.brd, linearni_zdroj.sch]
2022-02-09 kryty zdroje
    [aerodynamický tunel.stl, backplate.stl, uchytka desek.stl]
2022-02-10 zase sem se jednou ve škole něco naučil
    [linearni_zdroj.brd, linearni_zdroj.sch]
2022-02-10 zase chybka a pokračování v doku
    [backplate.stl]
2022-02-12 neumím malovat XD
    [linearni_zdroj.brd, linearni_zdroj.sch]
2022-02-12 pokračování v doku úklid schéma
    [linearni_zdroj.brd, linearni_zdroj.sch]
2022-02-14 Be my valentine From: Milan To: SOČka
    [odporyspinan.xlsx]
2022-02-19 Opravena nekomabilita s HW stále přetrvávají chyby mód 1 a korekce napětí
    [odporyspinan.xlsx]
2022-02-22 měření chyby ADC převodníku
    [ADC korekce.xlsx]
2022-02-22 oddělení od předchozích verzí zdroje
    [ADC korekce.xlsx, aerodynamický tunel.stl, backplate.stl, enkoder.brd, enkoder.sch, errorlist.xlsx, frontpanel.stl, krytka enkoderu v2.stl]
2022-02-22 Dokumentace ADC
    [ADC korekce.xlsx, spínaný zdroj.xlsx]
2022-02-22 Porekce ADC změna podmínek refresh
2022-03-03 přejmenovávání a finální úpravy
    [ADC korekce.xlsx, clona.stl, errorlist.xlsx, ovládací panel.stl, spínaný zdroj.xlsx, zadní kryt.stl, západka.stl]
2022-03-03 přejmenování
    [ADC korekce.xlsx, enkoder.brd, enkoder.sch, linearni_zdroj.brd, linearni_zdroj.sch, pulzní regulátor.brd, pulzní regulátor.sch, spínaný zdroj.xlsx]
2023-04-14 První verze zadního krytu s výstupem pro USB
    [zadní kryt.stl]
2023-06-30 Uprava FW pro příjímání a odesílání přes USB, nefunkční měření teploty
    [drzak_izolatoru.stl]
